FrantisekPospisil/F103_Soldering/Soldering_Schema.pdf

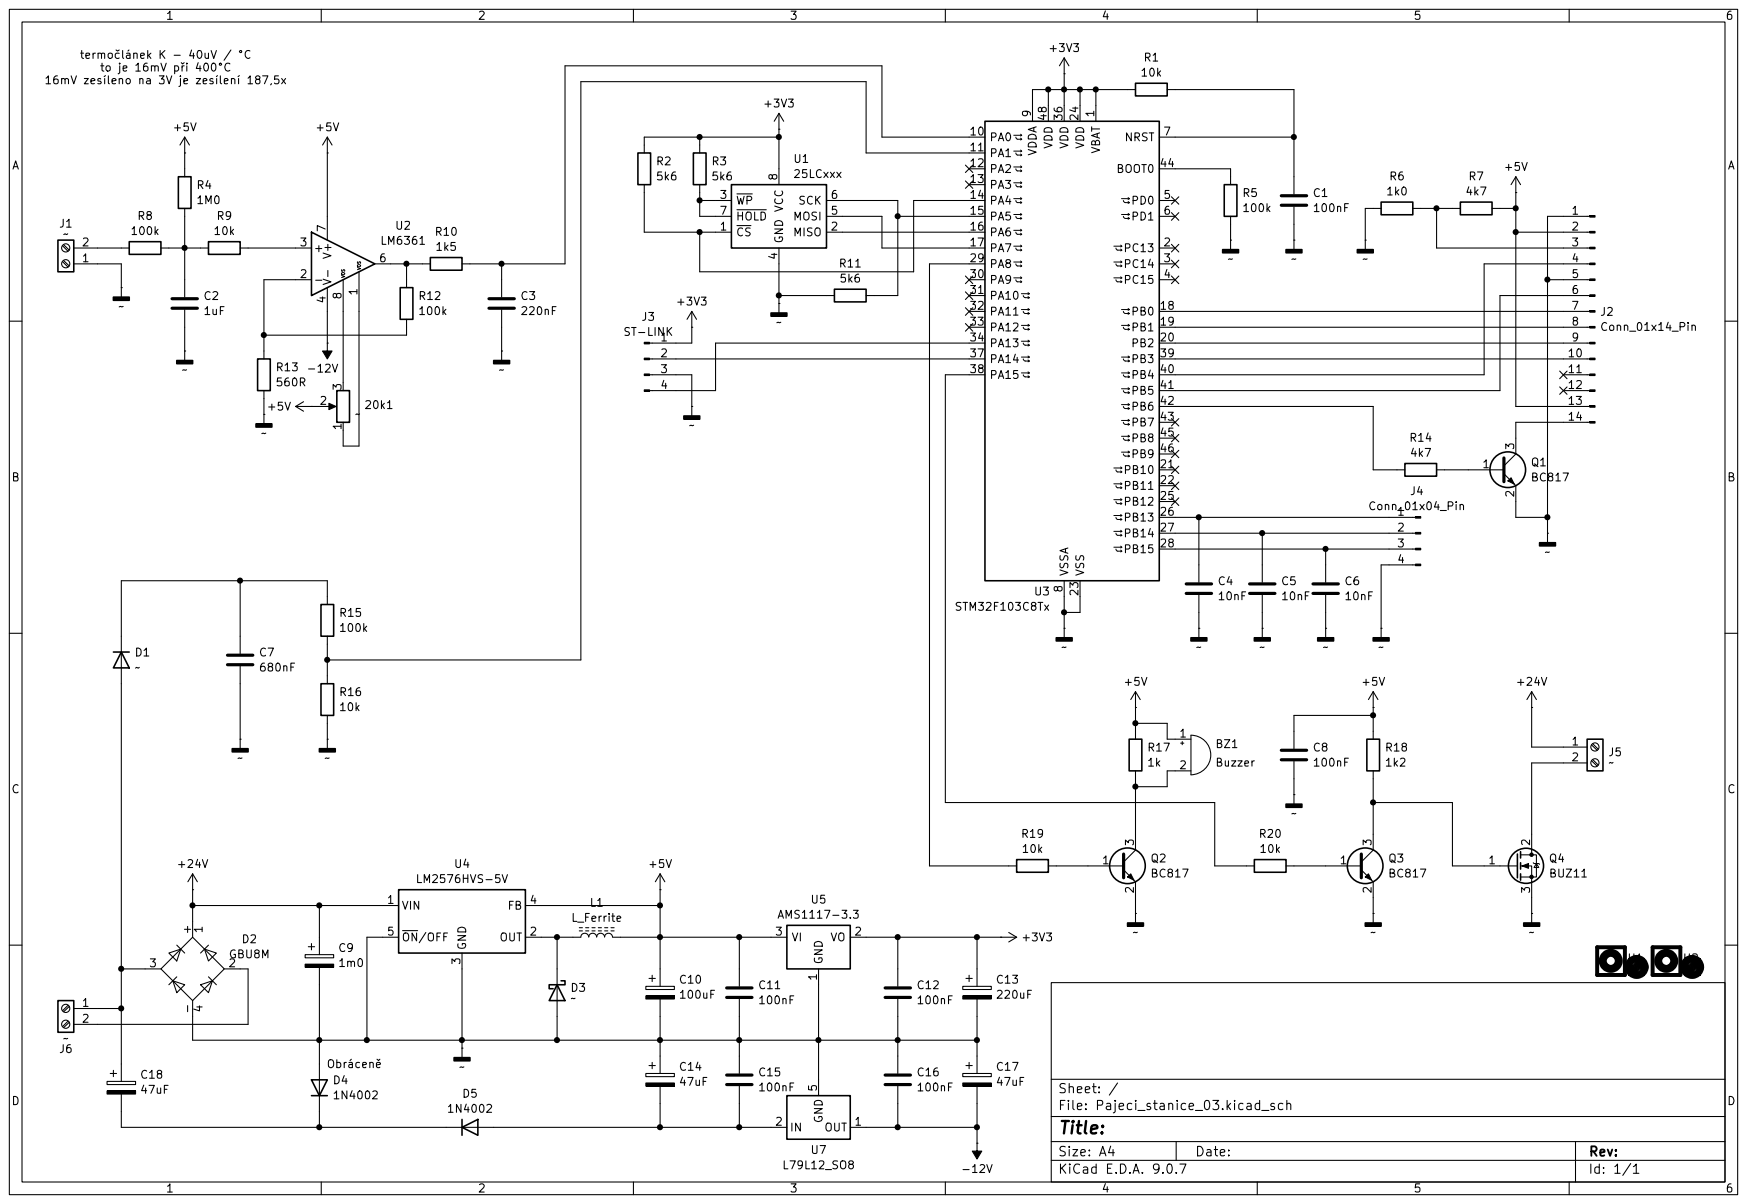
[picture p2: page 1]
