FrantisekPospisil/F103_Soldering/Core/Inc/main.h

#define TEMP_ABS_MAX_C01   4500u   /* tvrdy strop 450.0 C, nezavisly na nastavene teplote */
#define FAULT_ADC_OPEN     4000u   /* ADC u plneho rozsahu => odpojeny termoclanek / pero */
#define HEATER_FAULT_SEC   30u     /* sekund plneho vykonu bez ohrevu => porucha topeni/cidla */
#define PID_PERIOD_MS      25u     /* perioda regulacni smycky [ms] (40 Hz) */
#define FAULT_NO_IRON      0x01u   /* odpojene pero / rozpojeny termoclanek */
#define FAULT_OVERTEMP     0x02u   /* prekrocen tvrdy teplotni strop */
#define FAULT_HEATER       0x04u   /* topi naplno, ale teplota neroste */
#define FAULT_ADC          0x08u   /* zastavil se AD prevodnik / DMA (stara data) */
#define FAULT_RUNAWAY      0x10u   /* teplota roste, i kdyz je vykon nulovy (topi mimo kontrolu) */
#define TONE_START1        1100u   /* startovni melodie - oktavy 1100/2200/4400 */
#define TONE_START2        2200u
#define TONE_START3        4400u
#define TONE_CLICK         5100u   /* cvaknuti enkoderu a tlacitka */
#define TONE_ERROR          500u   /* chyba EEPROM - nizky ton (na piezu je slabsi) */
#define TONE_FAULT         4000u   /* opakovany alarm pri poruse */
#define TONE_ACK           3000u   /* potvrzeni poruchy tlacitkem */
#define TONE_D6            1175u   /* D6 - zakladni ton (1) */
#define TONE_E6            1319u   /* E6 - sekunda (2)     */
#define TONE_F6            1397u   /* F6 - mala tercie (b3) */
#define TONE_A6            1760u   /* A6 - kvinta (5)      */
#define SPI1_NSS_Pin LL_GPIO_PIN_4
#define SPI1_NSS_GPIO_Port GPIOA
#define D4_Pin LL_GPIO_PIN_0
#define D4_GPIO_Port GPIOB
#define D5_Pin LL_GPIO_PIN_1
#define D5_GPIO_Port GPIOB
#define D6_Pin LL_GPIO_PIN_2
#define D6_GPIO_Port GPIOB
#define Coder1_Pin LL_GPIO_PIN_13
#define Coder1_GPIO_Port GPIOB
#define Coder0_Pin LL_GPIO_PIN_14
#define Coder0_GPIO_Port GPIOB
#define Coder0_EXTI_IRQn EXTI15_10_IRQn
#define Button_Pin LL_GPIO_PIN_15
#define Button_GPIO_Port GPIOB
#define Button_EXTI_IRQn EXTI15_10_IRQn
#define Buzzer_Pin LL_GPIO_PIN_8
#define Buzzer_GPIO_Port GPIOA
#define D7_Pin LL_GPIO_PIN_3
#define D7_GPIO_Port GPIOB
#define LCD_RS_Pin LL_GPIO_PIN_4
#define LCD_RS_GPIO_Port GPIOB
#define LCD_E_Pin LL_GPIO_PIN_5
#define LCD_E_GPIO_Port GPIOB
#define LCD_LED_Pin LL_GPIO_PIN_6
#define LCD_LED_GPIO_Port GPIOB
